wzab/midi-wireless-guitar-system/README.md

midi-wireless-guitar-system
===========================

Digital wireless system with MIDI controls for electric guitar

The website of the project with detailed description is available at: 
http://koral.ise.pw.edu.pl/~wzab/wireless_guitar_system/

The project is based on the LUFA framework:
http://www.fourwalledcubicle.com/LUFA.php
(version 101122)
