wzab/midi-wireless-guitar-system/kicad-project/rx/rx.sch

## KiCad design kicad-project/rx/rx.sch (2013-01-11)

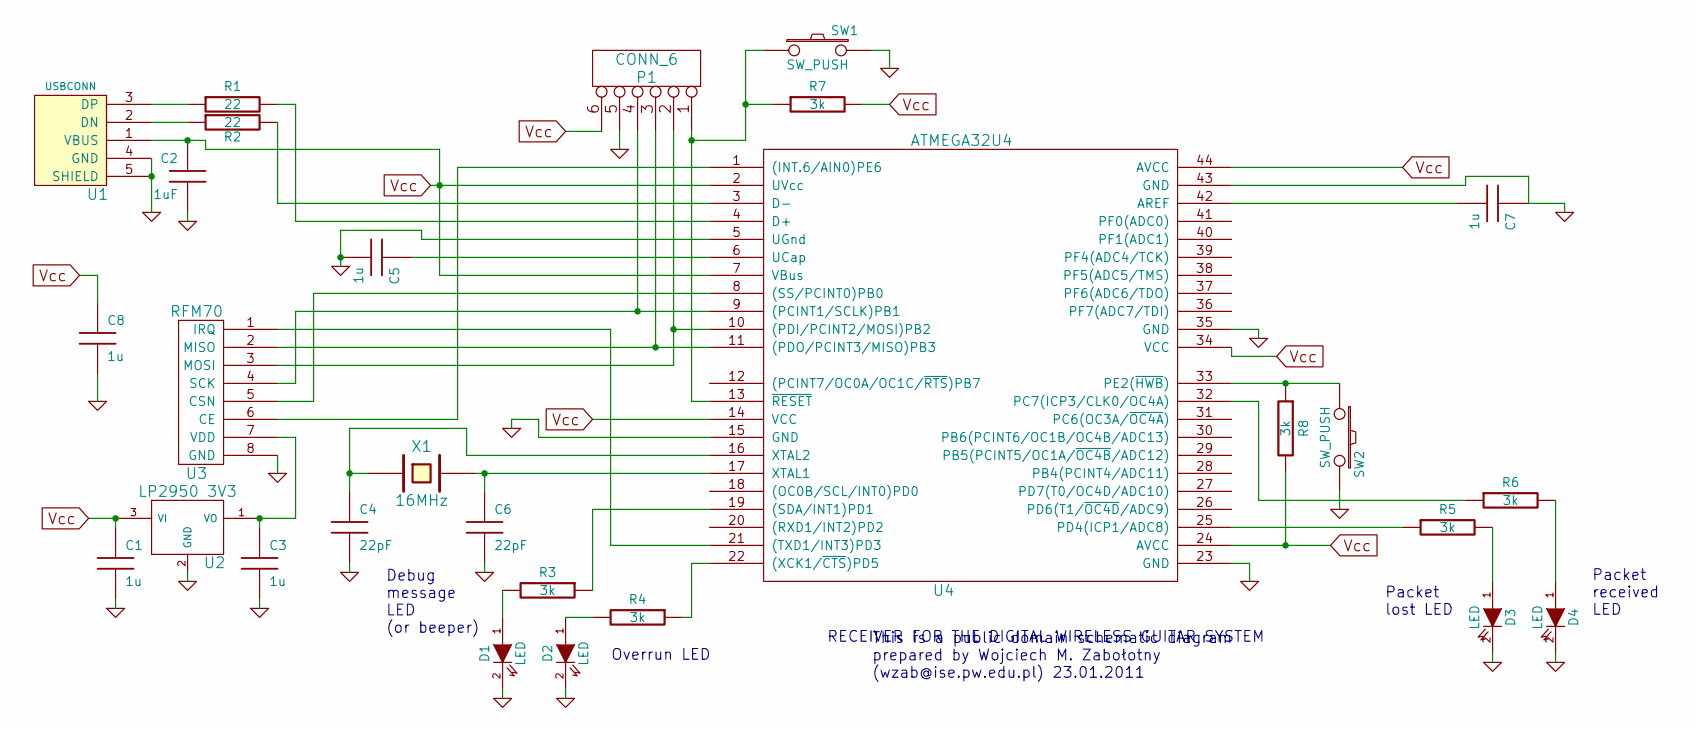
[picture p3: schematic rx.sch]

Parts:
C1, C3, C5, C7, C8: 1u
C2: 1uF
C4, C6: 22pF
D1, D2, D3, D4: LED
P1: CONN_6
R1, R2: 22
R3, R4, R5, R6, R7, R8: 3k
SW1, SW2: SW_PUSH
U1: USBCONN
U2: LP2950 3V3
U3: RFM70
U4: ATMEGA32U4
X1: 16MHz

Connections:
GND: C1.2, C2.2, C3.2, C4.2, C5.2, C6.2, C7.1, C8.2, D1.2 (K), D2.2 (K), D3.2 (K), D4.2 (K), P1.5, SW1.2, SW2.2, U1.4 (GND), U1.5 (SHIELD), U2.2 (GND), U3.8 (GND), U4.5 (UGnd), U4.15 (GND), U4.23 (GND), U4.35 (GND), U4.43 (GND)
unnamed: C3.1, U2.1 (VO), U3.7 (VDD)
unnamed: C4.1, U4.16 (XTAL2), X1.1
unnamed: C5.1, U4.6 (UCap)
unnamed: C6.1, U4.17 (XTAL1), X1.2
unnamed: C7.2, U4.42 (AREF)
unnamed: D1.1 (A), R3.2
unnamed: D2.1 (A), R4.2
unnamed: D3.1 (A), R5.2
unnamed: D4.1 (A), R6.2
unnamed: P1.1, R7.1, SW1.1, U4.13 (~RESET~)
unnamed: P1.2, U3.3 (MOSI), U4.10 ((PDI/PCINT2/MOSI)PB2)
unnamed: P1.3, U3.2 (MISO), U4.11 ((PDO/PCINT3/MISO)PB3)
unnamed: P1.4, U3.4 (SCK), U4.9 ((PCINT1/SCLK)PB1)
unnamed: R1.1, U1.3 (DP)
unnamed: R1.2, U4.4 (D+)
unnamed: R2.1, U1.2 (DN)
unnamed: R2.2, U4.3 (D-)
unnamed: R3.1, U4.19 ((SDA/INT1)PD1)
unnamed: R4.1, U4.22 ((XCK1/~CTS~)PD5)
unnamed: R5.1, U4.25 (PD4(ICP1/ADC8))
unnamed: R6.1, U4.32 (PC7(ICP3/CLK0/OC4A))
unnamed: R8.1, SW2.1, U4.33 (PE2(~HWB~))
unnamed: U3.1 (IRQ), U4.21 ((TXD1/INT3)PD3)
unnamed: U3.5 (CSN), U4.8 ((SS/PCINT0)PB0)
unnamed: U3.6 (CE), U4.1 ((INT.6/AIN0)PE6)
Vcc: C1.1, C2.1, C8.1, P1.6, R7.2, R8.2, U1.1 (VBUS), U2.3 (VI), U4.2 (UVcc), U4.7 (VBus), U4.14 (VCC), U4.24 (AVCC), U4.34 (VCC), U4.44 (AVCC)

Notes on the sheet:
Packet received LED
Debug message LED (or beeper)
This is a public domain schematic diagram prepared by Wojciech M. Zabołotny (wzab@ise.pw.edu.pl) 23.01.2011
RECEIVER FOR THE DIGITAL WIRELESS GUITAR SYSTEM
Packet lost LED
Overrun LED
