wzab/midi-wireless-guitar-system/kicad-project/tx/cs5343_4.sch

## KiCad design kicad-project/tx/cs5343_4.sch (2013-01-11)

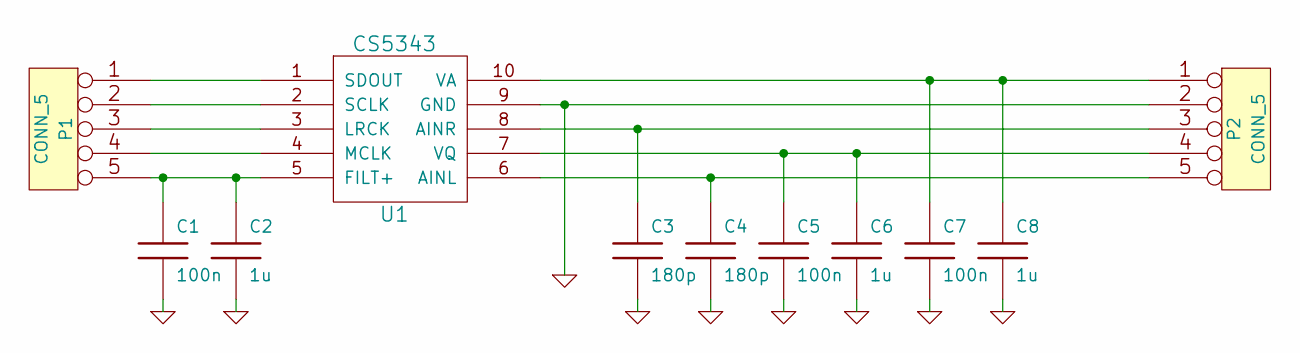
[picture p4: schematic cs5343_4.sch]

Parts:
C1, C5, C7: 100n
C2, C6, C8: 1u
C3, C4: 180p
P1, P2: CONN_5
U1: CS5343; TSSOP-10

Connections:
GND: C1.2, C2.2, C3.2, C4.2, C5.2, C6.2, C7.2, C8.2, P2.2, U1.9 (GND)
unnamed: C1.1, C2.1, P1.5, U1.5 (FILT+)
unnamed: C3.1, P2.3, U1.8 (AINR)
unnamed: C4.1, P2.5, U1.6 (AINL)
unnamed: C5.1, C6.1, P2.4, U1.7 (VQ)
unnamed: C7.1, C8.1, P2.1, U1.10 (VA)
unnamed: P1.1, U1.1 (SDOUT)
unnamed: P1.2, U1.2 (SCLK)
unnamed: P1.3, U1.3 (LRCK)
unnamed: P1.4, U1.4 (MCLK)
