wzab/midi-wireless-guitar-system/kicad-project/tx/tx.sch

## KiCad design kicad-project/tx/tx.sch (2013-01-11)

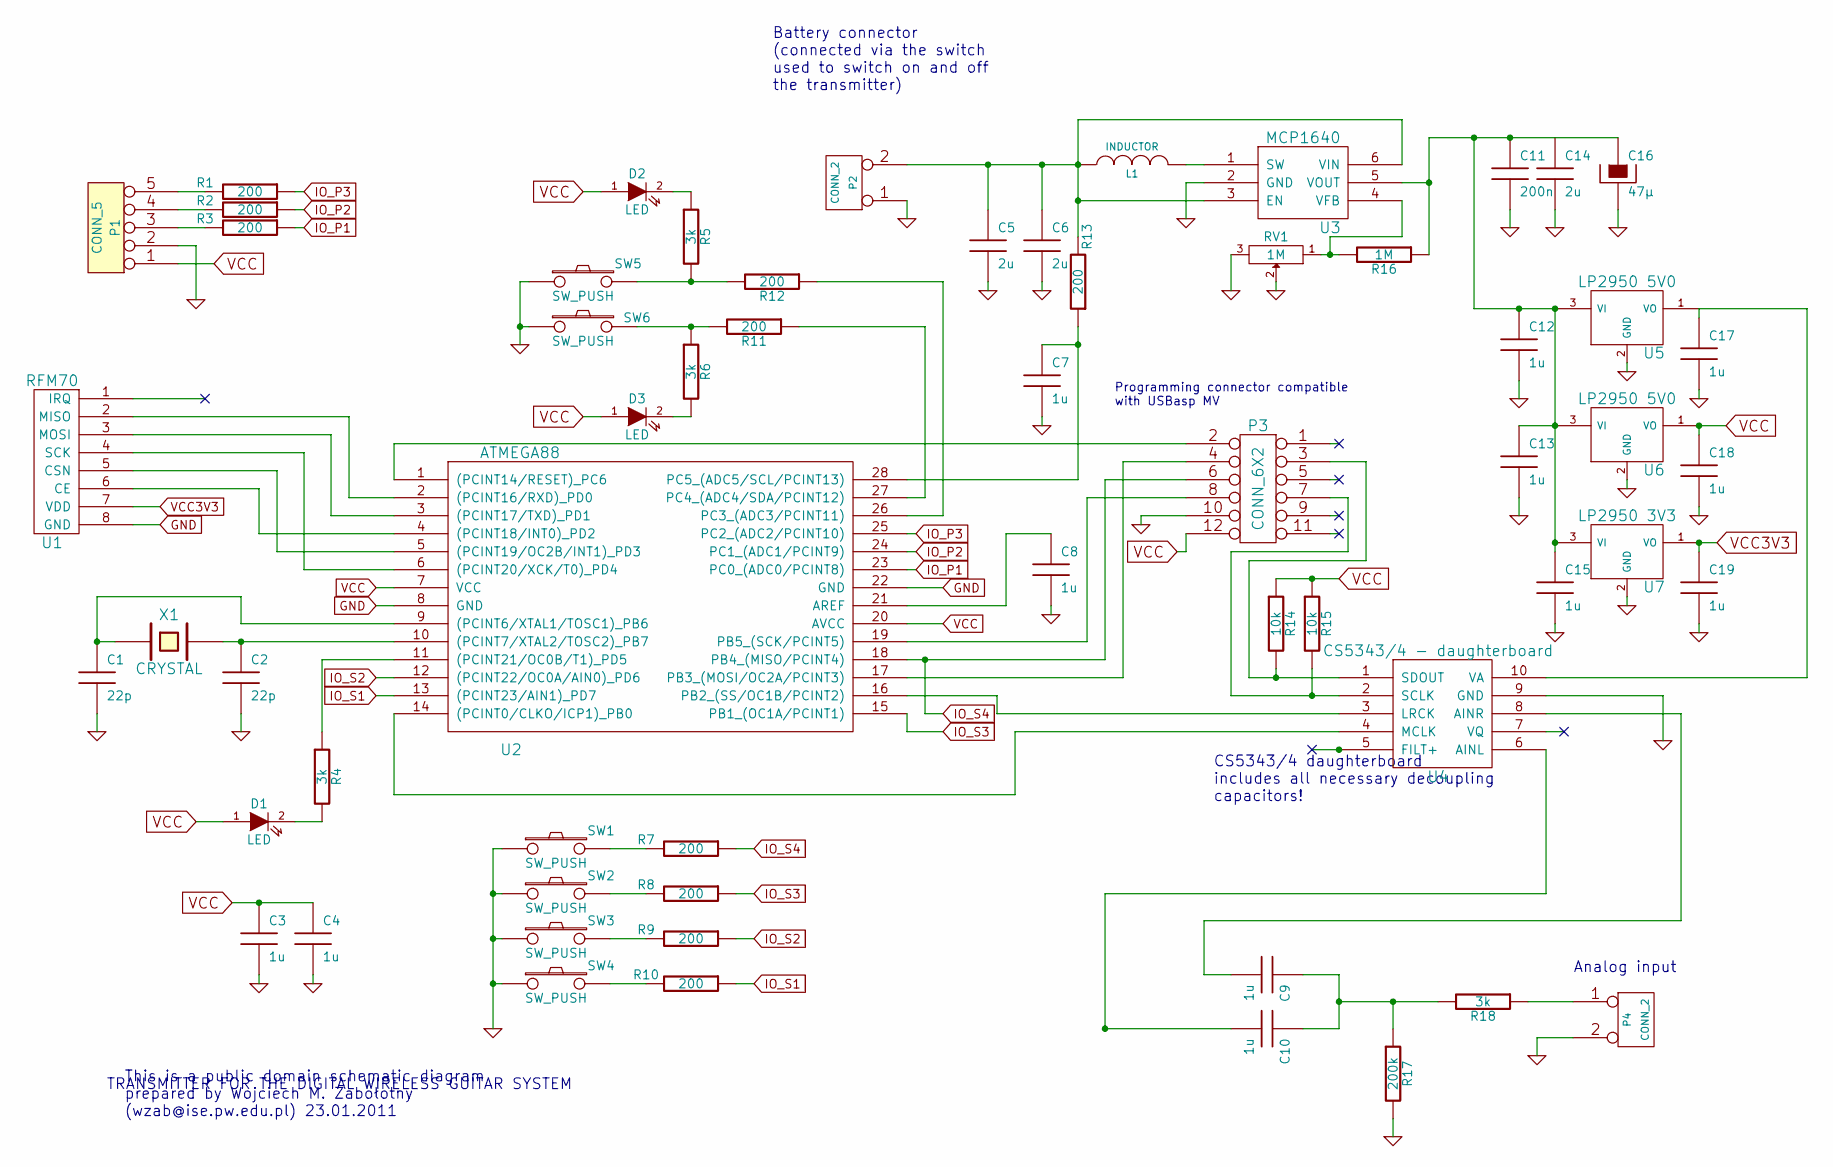
[picture p5: schematic tx.sch]

Parts:
C1, C2: 22p
C3, C4, C7, C8, C9, C10, C12, C13, C15, C17, C18, C19: 1u
C5, C6, C14: 2u
C11: 200n
C16: 47µ
D1, D2, D3: LED
L1: INDUCTOR
P1: CONN_5
P2, P4: CONN_2
P3: CONN_6X2
R1, R2, R3, R7, R8, R9, R10, R11, R12, R13: 200
R4, R5, R6, R18: 3k
R14, R15: 10k
R16: 1M
R17: 200k
RV1: 1M
SW1, SW2, SW3, SW4, SW5, SW6: SW_PUSH
U1: RFM70
U2: ATMEGA88
U3: MCP1640
U4: CS5343/4 - daughterboard; TSSOP-10
U5, U6: LP2950 5V0
U7: LP2950 3V3
X1: CRYSTAL

Connections:
GND: C1.2, C2.2, C3.2, C4.2, C5.2, C6.2, C7.2, C8.2, C11.2, C12.2, C13.2, C14.2, C15.2, C16.2, C17.2, C18.2, C19.2, P1.2, P2.1, P3.10, P4.2 (PM), R17.2, RV1.2, RV1.3, SW1.1, SW2.1, SW3.1, SW4.1, SW5.1, SW6.1, U1.8 (GND), U2.8 (GND), U2.22 (GND), U3.2 (GND), U4.9 (GND), U5.2 (GND), U6.2 (GND), U7.2 (GND)
IO_P1: R3.1, U2.23 (PC0_(ADC0/PCINT8))
IO_P2: R2.1, U2.24 (PC1_(ADC1/PCINT9))
IO_P3: R1.1, U2.25 (PC2_(ADC2/PCINT10))
IO_S1: R10.1, U2.13 ((PCINT23/AIN1)_PD7)
IO_S2: R9.1, U2.12 ((PCINT22/OC0A/AIN0)_PD6)
IO_S3: R8.1, U2.15 (PB1_(OC1A/PCINT1))
IO_S4: P3.6, R7.1, U2.18 (PB4_(MISO/PCINT4))
unnamed: C1.1, U2.9 ((PCINT6/XTAL1/TOSC1)_PB6), X1.1
unnamed: C2.1, U2.10 ((PCINT7/XTAL2/TOSC2)_PB7), X1.2
unnamed: C5.1, C6.1, L1.1, P2.2 (PM), R13.2, U3.3 (EN), U3.6 (VIN)
unnamed: C7.1, R13.1, U2.28 (PC5_(ADC5/SCL/PCINT13))
unnamed: C8.1, U2.21 (AREF)
unnamed: C9.2, U4.8 (AINR)
unnamed: C9.1, C10.1, R17.1, R18.2
unnamed: C10.2, U4.6 (AINL)
unnamed: C11.1, C12.1, C13.1, C15.1, C16.1, R16.1, U3.5 (VOUT), U5.3 (VI), U6.3 (VI), U7.3 (VI)
unnamed: C17.1, U4.10 (VA), U5.1 (VO)
unnamed: D1.2 (K), R4.2
unnamed: D2.2 (K), R5.1
unnamed: D3.2 (K), R6.2
unnamed: L1.2, U3.1 (SW)
unnamed: P1.3, R3.2
unnamed: P1.4, R2.2
unnamed: P1.5, R1.2
unnamed: P3.2, U2.1 ((PCINT14/RESET)_PC6)
unnamed: P3.3, R14.2, U4.1 (SDOUT)
unnamed: P3.4, U2.17 (PB3_(MOSI/OC2A/PCINT3))
unnamed: P3.7, R15.2, U4.2 (SCLK)
unnamed: P3.8, U2.19 (PB5_(SCK/PCINT5))
unnamed: P4.1, R18.1
unnamed: R4.1, U2.11 ((PCINT21/OC0B/T1)_PD5)
unnamed: R7.2, SW1.2
unnamed: R8.2, SW2.2
unnamed: R9.2, SW3.2
unnamed: R10.2, SW4.2
unnamed: R11.1, U2.27 (PC4_(ADC4/SDA/PCINT12))
unnamed: R6.1, R11.2, SW6.2
unnamed: R12.1, U2.26 (PC3_(ADC3/PCINT11))
unnamed: R5.2, R12.2, SW5.2
unnamed: R16.2, RV1.1, U3.4 (VFB)
unnamed: U1.2 (MISO), U2.2 ((PCINT16/RXD)_PD0)
unnamed: U1.3 (MOSI), U2.3 ((PCINT17/TXD)_PD1)
unnamed: U1.4 (SCK), U2.6 ((PCINT20/XCK/T0)_PD4)
unnamed: U1.5 (CSN), U2.5 ((PCINT19/OC2B/INT1)_PD3)
unnamed: U1.6 (CE), U2.4 ((PCINT18/INT0)_PD2)
unnamed: U2.14 ((PCINT0/CLKO/ICP1)_PB0), U4.4 (MCLK)
unnamed: U2.16 (PB2_(SS/OC1B/PCINT2)), U4.3 (LRCK)
VCC: C3.1, C4.1, C18.1, D1.1 (A), D2.1 (A), D3.1 (A), P1.1, P3.12, R14.1, R15.1, U2.7 (VCC), U2.20 (AVCC), U6.1 (VO)
VCC3V3: C19.1, U1.7 (VDD), U7.1 (VO)

Notes on the sheet:
CS5343/4 daughterboard includes all necessary decoupling capacitors!
TRANSMITTER FOR THE DIGITAL WIRELESS GUITAR SYSTEM
This is a public domain schematic diagram prepared by Wojciech M. Zabołotny (wzab@ise.pw.edu.pl) 23.01.2011
Analog input
Battery connector (connected via the switch used to switch on and off the transmitter)
Programming connector compatible with USBasp MV
