wzab/midi-wireless-guitar-system/kicad-project/tx/tx_io.sch

## KiCad design kicad-project/tx/tx_io.sch (2013-01-11)

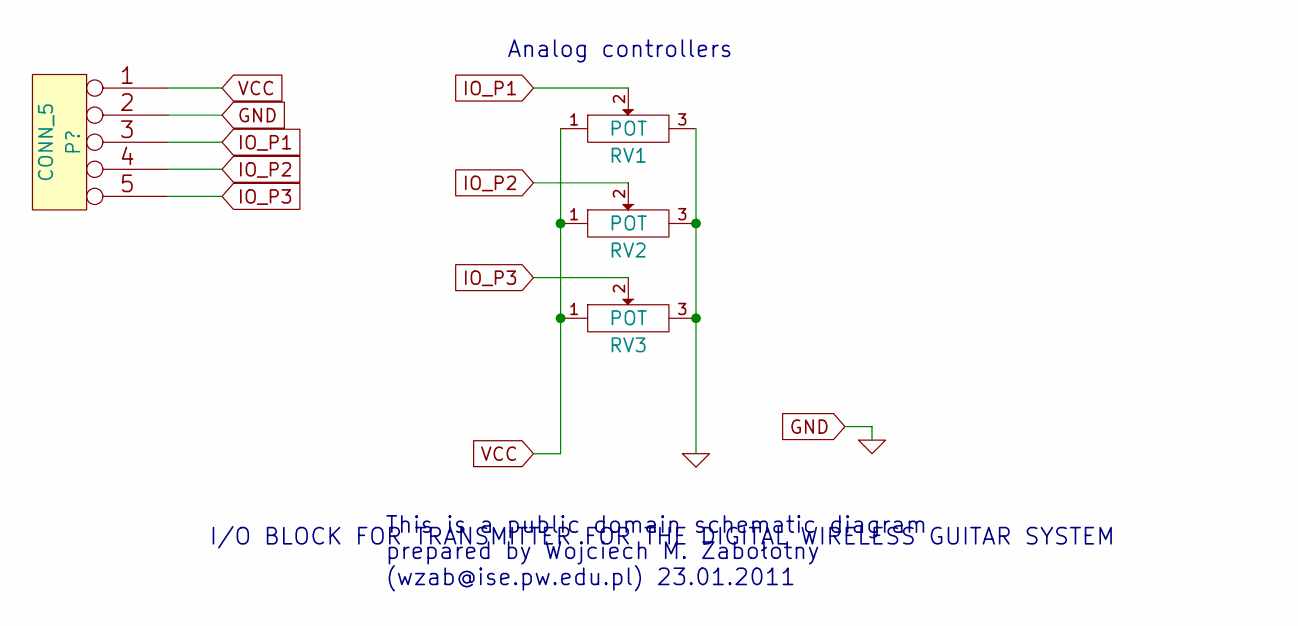
[picture p6: schematic tx_io.sch]

Parts:
RV1, RV2, RV3: POT

Connections:
GND: RV1.3, RV2.3, RV3.3
IO_P1: RV1.2
IO_P2: RV2.2
IO_P3: RV3.2
VCC: RV1.1, RV2.1, RV3.1

Notes on the sheet:
I/O BLOCK FOR TRANSMITTER FOR THE DIGITAL WIRELESS GUITAR SYSTEM
This is a public domain schematic diagram prepared by Wojciech M. Zabołotny (wzab@ise.pw.edu.pl) 23.01.2011
Analog controllers
